roberben/Linker32/IMAGES/esquemaSemiReal.png

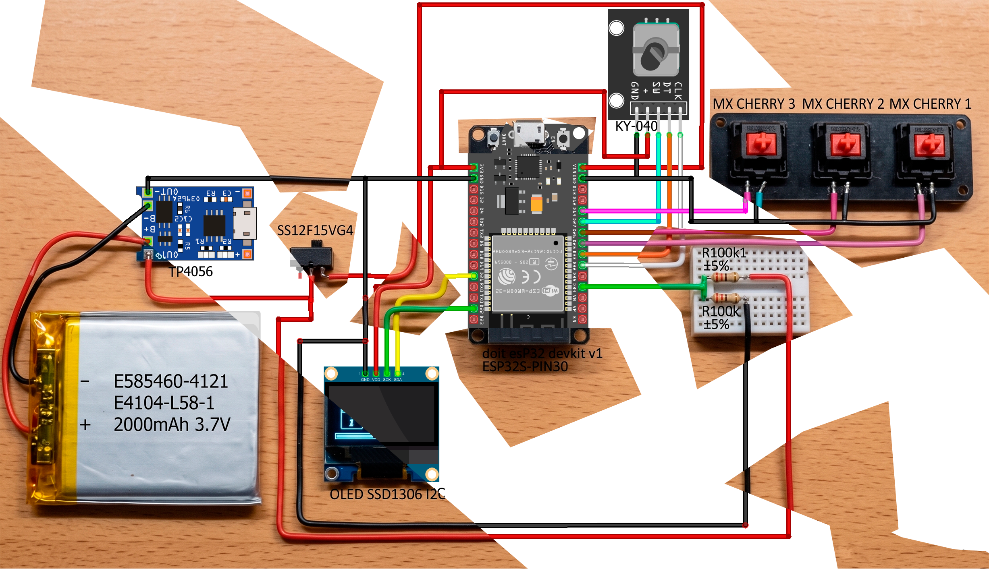
IMAGES/esquemaSemiReal.png
