roberben/Linker32/(commit log)

2026-05-18 Nuevas imagenes de Linker32 y Mixer32
2026-05-18 imgs de Periférico MIXER32
2026-05-19 Enhance README with OTA and PlatformIO details
    Updated the OTA system description to include cable support and migrated the installation instructions to PlatformIO.
2026-05-20 Actualiza README añadiendo opción de Instalador Web
